nopasara/joystick/KiCad proj/joystick/joystick.kicad_pcb

## KiCad design KiCad proj/joystick/joystick.kicad_pcb (2022-01-29)

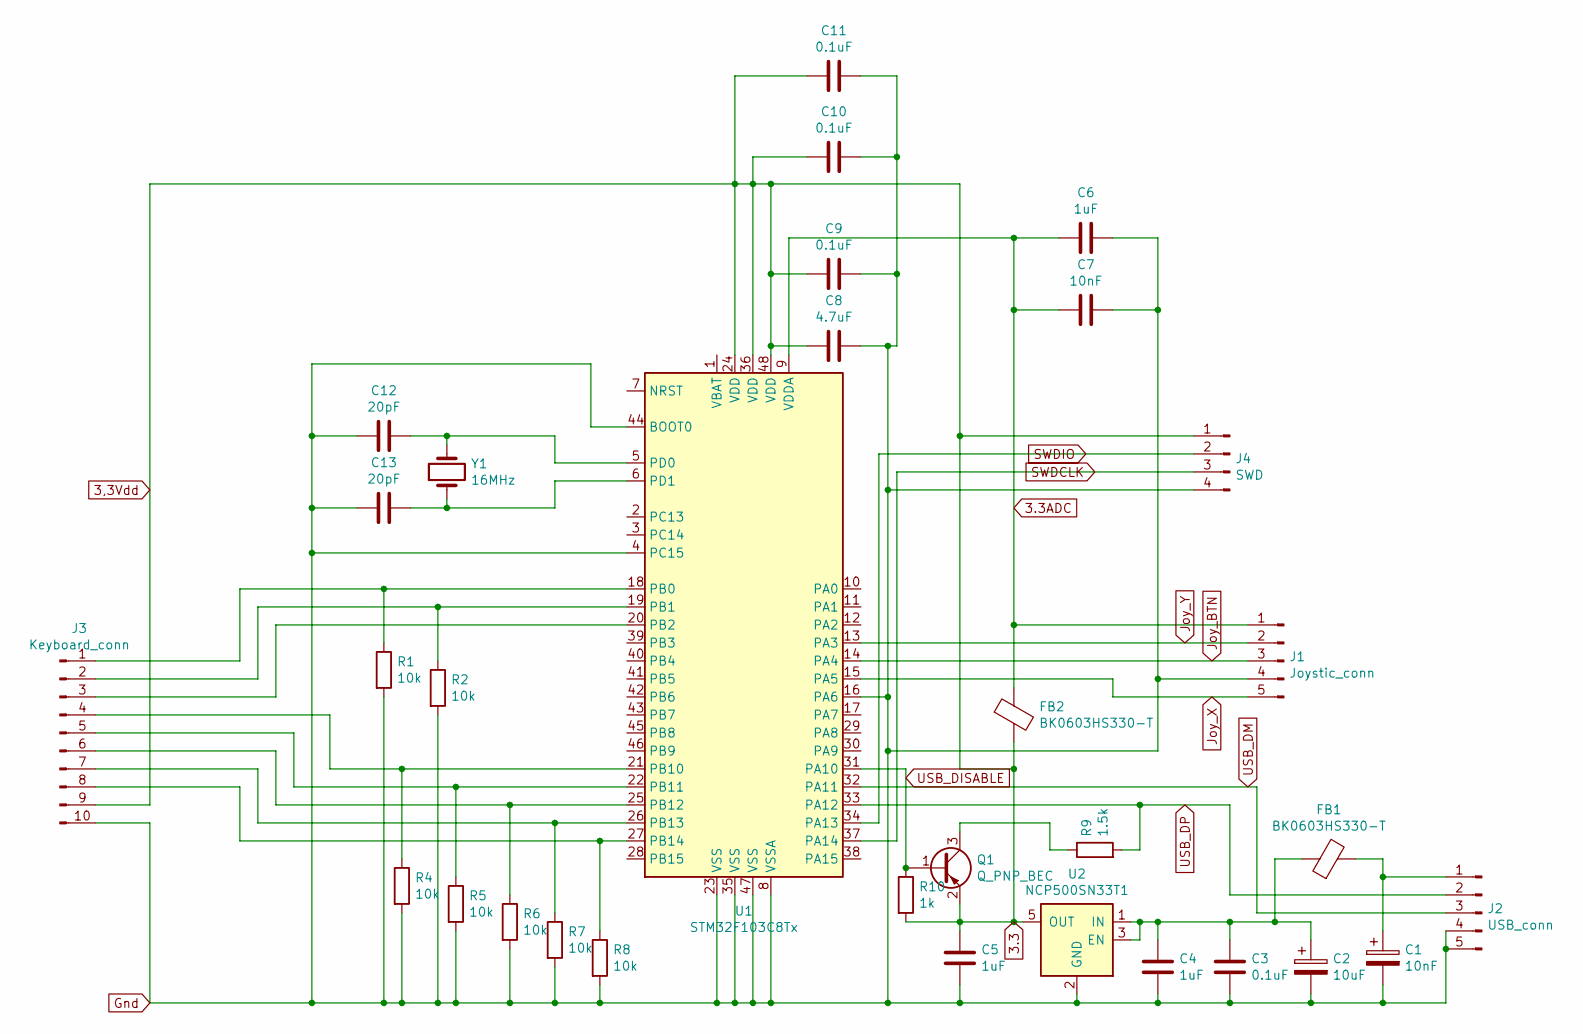
[picture p1: schematic joystick.sch]

Parts:
C1, C7: 10nF; C_0603_1608Metric_Pad1.08x0.95mm_HandSolder
C2: 10uF; CP_Radial_D5.0mm_P2.50mm
C3, C9, C10, C11: 0.1uF; C_0805_2012Metric_Pad1.18x1.45mm_HandSolder
C4, C5, C6: 1uF; C_0805_2012Metric_Pad1.18x1.45mm_HandSolder
C8: 4.7uF; CP_Radial_D5.0mm_P2.50mm
C12, C13: 20pF; C_0603_1608Metric_Pad1.08x0.95mm_HandSolder
FB1, FB2: BK0603HS330-T; R_0603_1608Metric_Pad0.98x0.95mm_HandSolder
J1: Joystic_conn; FPC-5P-0.5mm
J2: USB_conn; PinHeader_1x05_P2.54mm_Vertical
J3: Keyboard_conn; Hirose_FH12-10S-0.5SH_1x10-1MP_P0.50mm_Horizontal
J4: SWD; PinHeader_1x04_P2.54mm_Vertical
Q1: Q_PNP_BEC; SOT-23
R1, R2, R4, R5, R6, R7, R8: 10k; R_0201_0603Metric_Pad0.64x0.40mm_HandSolder
R9: 1.5k; C_0805_2012Metric_Pad1.18x1.45mm_HandSolder
R10: 1k; R_0603_1608Metric_Pad0.98x0.95mm_HandSolder
U1: STM32F103C8Tx; LQFP-48_7x7mm_P0.5mm
U2: NCP500SN33T1; TSOP-5_1.65x3.05mm_P0.95mm
Y1: 16MHz; Crystal_HC49-S_Vertical

Connections:
3,3Vdd: C5.1, C8.1, C9.1, C10.1, C11.1, FB2.2, J3.9, J4.1, Q1.2 (E), R10.2, U1.24 (VDD), U1.36 (VDD), U1.48 (VDD), U2.5 (OUT)
3.3ADC: C6.1, C7.1, FB2.1, J1.1, U1.9 (VDDA)
Gnd: C1.2, C2.2, C3.2, C4.2, C5.2, C6.2, C7.2, C8.2, C9.2, C10.2, C11.2, C12.1, C13.1, J1.4, J2.4, J2.5, J3.10, J4.4, R1.2, R2.2, R4.2, R5.2, R6.2, R7.2, R8.2, U1.4 (PC15), U1.8 (VSSA), U1.16 (PA6), U1.23 (VSS), U1.35 (VSS), U1.44 (BOOT0), U1.47 (VSS), U2.2 (GND)
Joy_BTN: J1.3, U1.14 (PA4)
Joy_X: J1.5, U1.15 (PA5)
Joy_Y: J1.2, U1.13 (PA3)
unnamed: C1.1, FB1.2, J2.1
unnamed: C2.1, C3.1, C4.1, FB1.1, U2.1 (IN), U2.3 (EN)
unnamed: C12.2, U1.5 (PD0), Y1.2
unnamed: C13.2, U1.6 (PD1), Y1.1
unnamed: J3.1, R1.1, U1.18 (PB0)
unnamed: J3.2, R2.1, U1.19 (PB1)
unnamed: J3.3, U1.20 (PB2)
unnamed: J3.4, R4.1, U1.21 (PB10)
unnamed: J3.5, R5.1, U1.22 (PB11)
unnamed: J3.6, R6.1, U1.25 (PB12)
unnamed: J3.7, R7.1, U1.26 (PB13)
unnamed: J3.8, R8.1, U1.27 (PB14)
unnamed: Q1.3 (C), R9.1
SWDCLK: J4.3, U1.37 (PA14)
SWDIO: J4.2, U1.34 (PA13)
USB_DISABLE: Q1.1 (B), R10.1, U1.31 (PA10)
USB_DM: J2.3, U1.32 (PA11)
USB_DP: J2.2, R9.2, U1.33 (PA12)

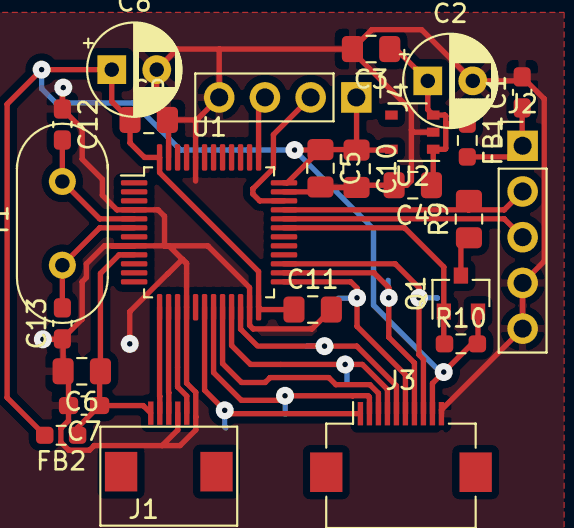
[picture p2: board joystick.kicad_pcb from above]

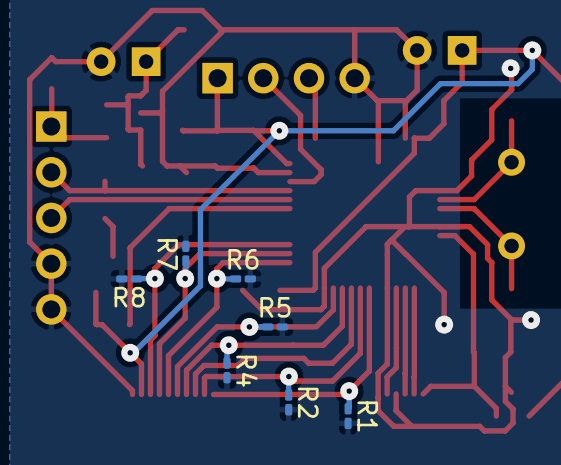
[picture p3: board joystick.kicad_pcb from below]

Board: 2 copper layers, 32 parts (7 on the bottom side), 24 nets.
