nopasara/joystick/KiCad proj/stick_adaptor2/stick_adaptor2.kicad_pcb

## KiCad design KiCad proj/stick_adaptor2/stick_adaptor2.kicad_pcb (2022-01-29)

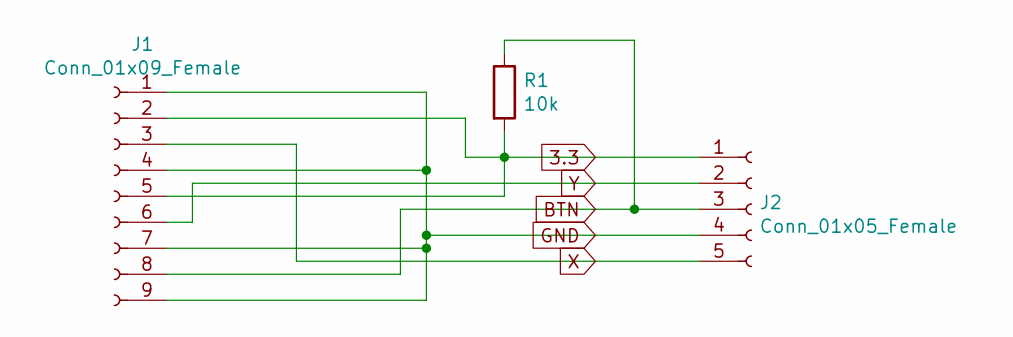
[picture p4: schematic stick_adaptor2.sch]

Parts:
J1: Conn_01x09_Female; Stick_china
J2: Conn_01x05_Female; PinHeader_1x05_P1.27mm_Vertical
R1: 10k; R_0603_1608Metric_Pad0.98x0.95mm_HandSolder

Connections:
3.3: J1.2, J1.5, J2.1, R1.2
BTN: J1.8, J2.3, R1.1
GND: J1.1, J1.4, J1.7, J1.9, J2.4
X: J1.3, J2.5
Y: J1.6, J2.2

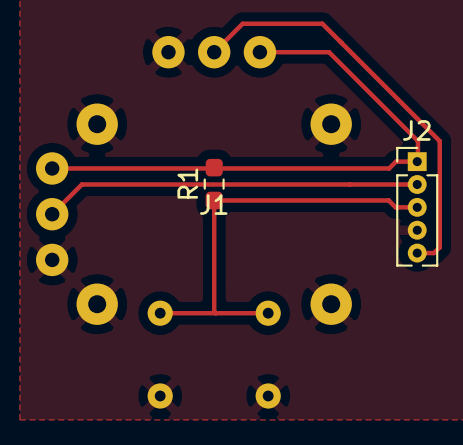
[picture p5: board stick_adaptor2.kicad_pcb from above]

Board: 2 copper layers, 3 parts (0 on the bottom side), 5 nets.
