nopasara/joystick/KiCad proj/joystick_v2/joystick_v2.kicad_pcb

## KiCad design KiCad proj/joystick_v2/joystick_v2.kicad_pcb (2022-01-29)

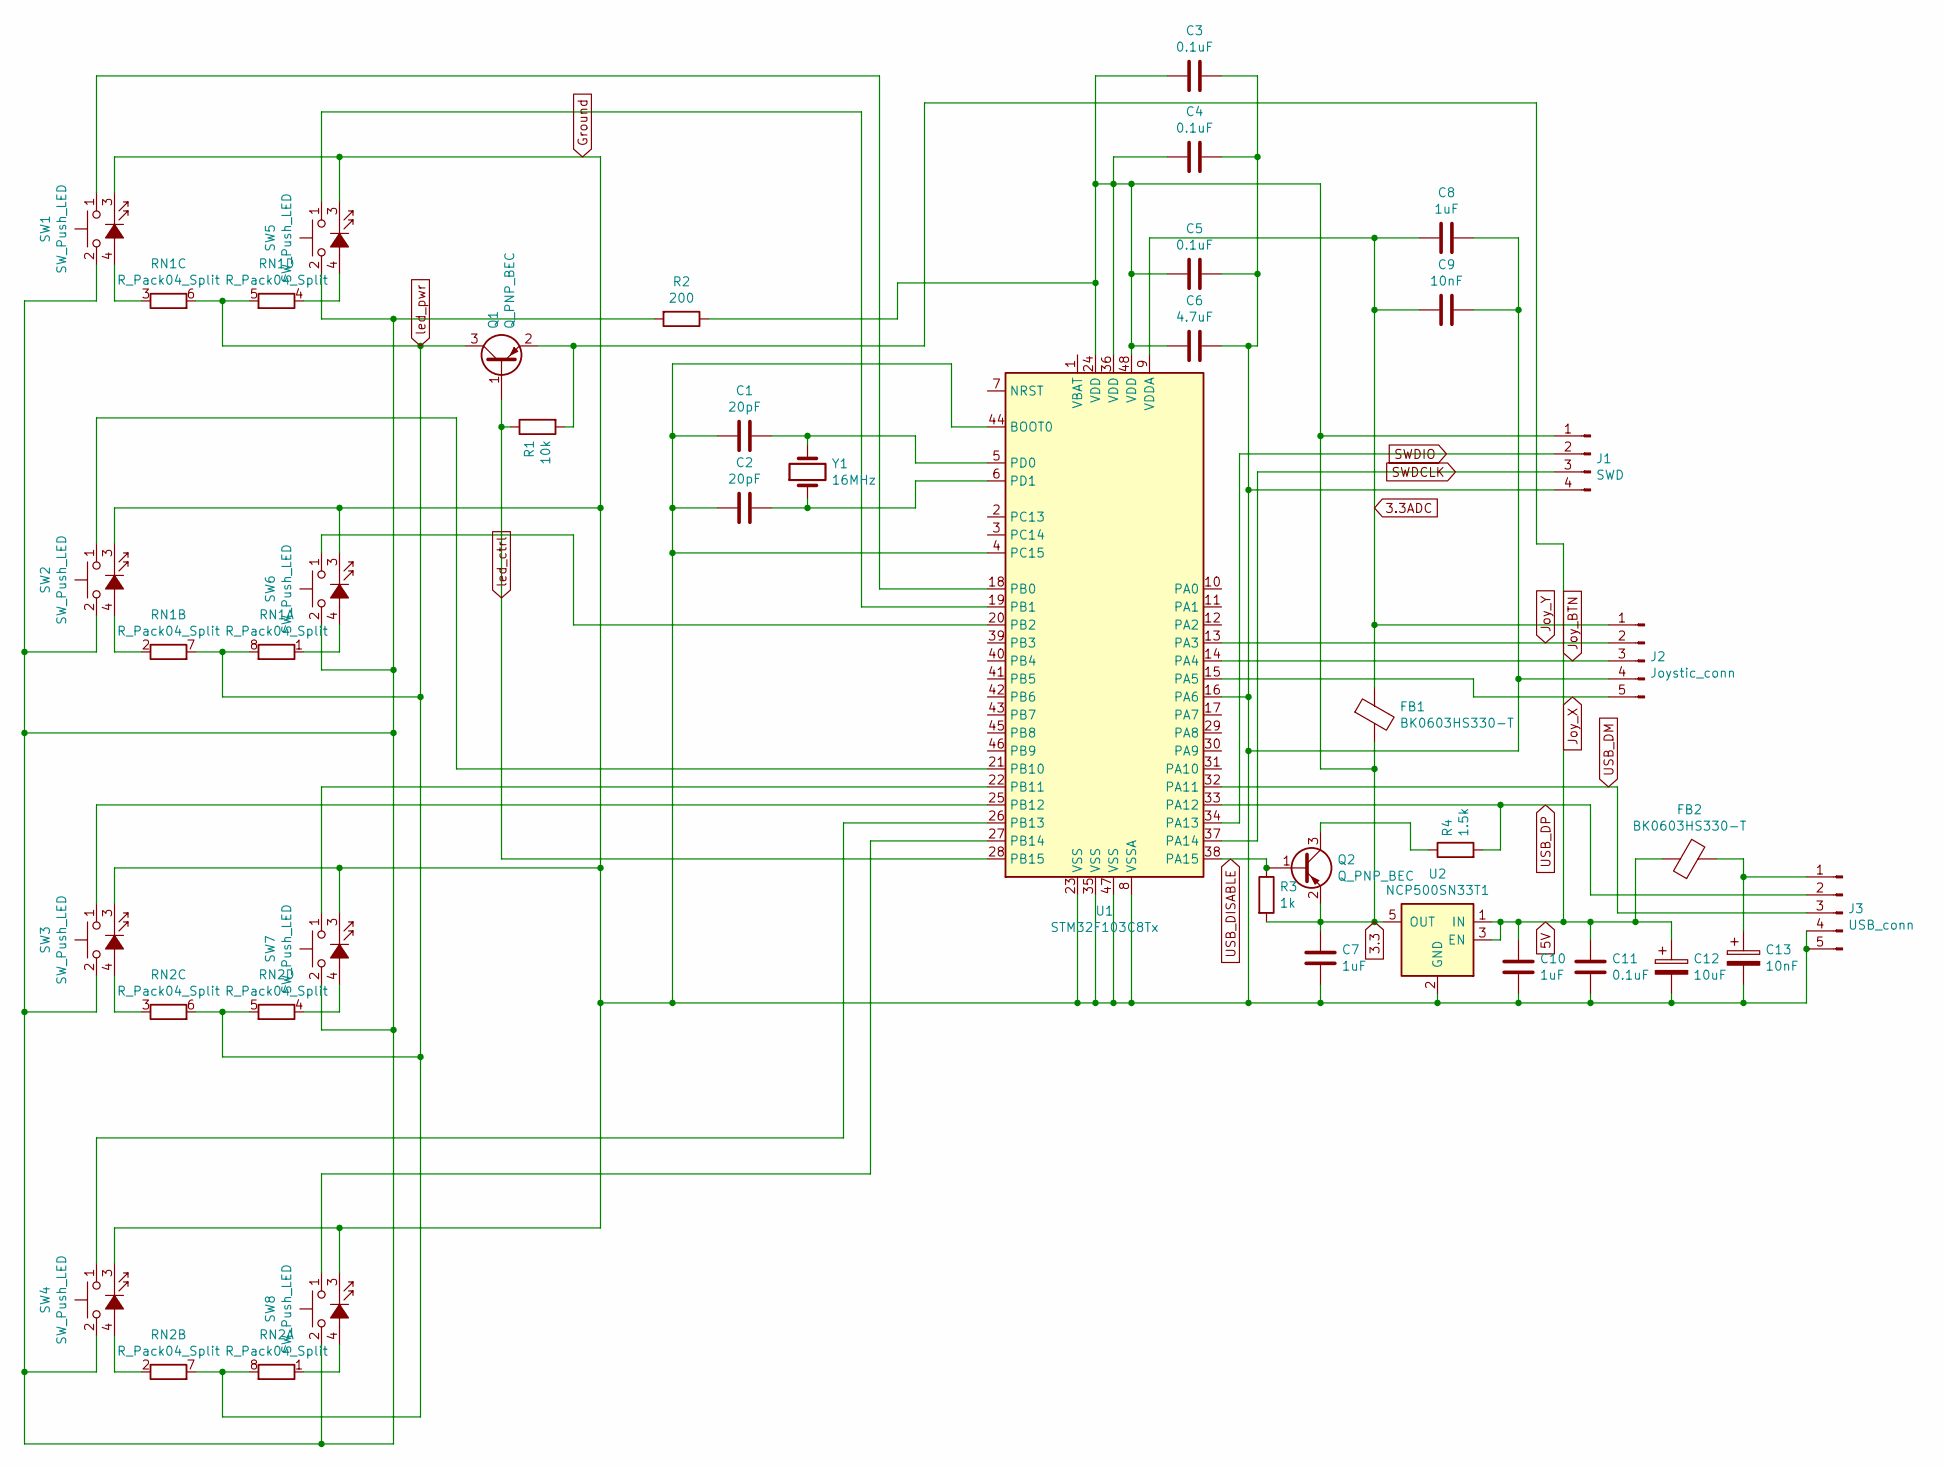
[picture p6: schematic joystick_v2.sch]

Parts:
C1, C2: 20pF; C_0603_1608Metric_Pad1.08x0.95mm_HandSolder
C3, C4, C5, C11: 0.1uF; C_0805_2012Metric_Pad1.18x1.45mm_HandSolder
C6: 4.7uF; CP_Radial_D5.0mm_P2.50mm
C7, C8, C10: 1uF; C_0805_2012Metric_Pad1.18x1.45mm_HandSolder
C9, C13: 10nF; C_0603_1608Metric_Pad1.08x0.95mm_HandSolder
C12: 10uF; CP_Radial_D5.0mm_P2.50mm
FB1, FB2: BK0603HS330-T; R_0603_1608Metric_Pad0.98x0.95mm_HandSolder
J1: SWD; PinHeader_1x04_P2.54mm_Vertical
J2: Joystic_conn; PinHeader_1x05_P1.27mm_Vertical
J3: USB_conn; PinHeader_1x05_P2.54mm_Vertical
Q1, Q2: Q_PNP_BEC; SOT-23
R1: 10k; R_0603_1608Metric_Pad0.98x0.95mm_HandSolder
R2: 200; R_0603_1608Metric_Pad0.98x0.95mm_HandSolder
R3: 1k; R_0603_1608Metric_Pad0.98x0.95mm_HandSolder
R4: 1.5k; C_0805_2012Metric_Pad1.18x1.45mm_HandSolder
RN1, RN2: R_Pack04_Split; R_Cat16-4
SW1, SW2, SW3, SW4, SW5, SW6, SW7, SW8: SW_Push_LED; SW_Cherry_MX_1.00u_Plate_diode
U1: STM32F103C8Tx; LQFP-48_7x7mm_P0.5mm
U2: NCP500SN33T1; TSOP-5_1.65x3.05mm_P0.95mm
Y1: 16MHz; Crystal_HC49-S_Vertical

Connections:
3.3: C3.1, C4.1, C5.1, C6.1, C7.1, FB1.2, J1.1, Q2.2 (E), R2.1, R3.2, U1.24 (VDD), U1.36 (VDD), U1.48 (VDD), U2.5 (OUT)
3.3ADC: C8.1, C9.1, FB1.1, J2.1, U1.9 (VDDA)
5V: C10.1, C11.1, C12.1, FB2.1, Q1.2 (E), R1.2, U2.1 (IN), U2.3 (EN)
Ground: C1.1, C2.1, C3.2, C4.2, C5.2, C6.2, C7.2, C8.2, C9.2, C10.2, C11.2, C12.2, C13.2, J1.4, J2.4, J3.4, J3.5, SW1.3 (K), SW2.3 (K), SW3.3 (K), SW4.3 (K), SW5.3 (K), SW6.3 (K), SW7.3 (K), SW8.3 (K), U1.4 (PC15), U1.8 (VSSA), U1.16 (PA6), U1.23 (VSS), U1.35 (VSS), U1.44 (BOOT0), U1.47 (VSS), U2.2 (GND)
Joy_BTN: J2.3, U1.14 (PA4)
Joy_X: J2.5, U1.15 (PA5)
Joy_Y: J2.2, U1.13 (PA3)
unnamed: C1.2, U1.5 (PD0), Y1.2
unnamed: C2.2, U1.6 (PD1), Y1.1
unnamed: C13.1, FB2.2, J3.1
unnamed: Q2.3 (C), R4.1
unnamed: R2.2, SW1.2, SW2.2, SW3.2, SW4.2, SW5.2, SW6.2, SW7.2, SW8.2
unnamed: RN1.1 (R1.1), SW6.4 (A)
unnamed: RN1.2 (R2.1), SW2.4 (A)
unnamed: RN1.3 (R3.1), SW1.4 (A)
unnamed: RN1.4 (R4.1), SW5.4 (A)
unnamed: RN2.1 (R1.1), SW8.4 (A)
unnamed: RN2.2 (R2.1), SW4.4 (A)
unnamed: RN2.3 (R3.1), SW3.4 (A)
unnamed: RN2.4 (R4.1), SW7.4 (A)
unnamed: SW1.1, U1.18 (PB0)
unnamed: SW2.1, U1.21 (PB10)
unnamed: SW3.1, U1.25 (PB12)
unnamed: SW4.1, U1.26 (PB13)
unnamed: SW5.1, U1.19 (PB1)
unnamed: SW6.1, U1.20 (PB2)
unnamed: SW7.1, U1.22 (PB11)
unnamed: SW8.1, U1.27 (PB14)
SWDCLK: J1.3, U1.37 (PA14)
SWDIO: J1.2, U1.34 (PA13)
USB_DISABLE: Q2.1 (B), R3.1, U1.38 (PA15)
USB_DM: J3.3, U1.32 (PA11)
USB_DP: J3.2, R4.2, U1.33 (PA12)
led_ctrl: Q1.1 (B), R1.1, U1.28 (PB15)
led_pwr: Q1.3 (C), RN1.5 (R4.2), RN1.6 (R3.2), RN1.7 (R2.2), RN1.8 (R1.2), RN2.5 (R4.2), RN2.6 (R3.2), RN2.7 (R2.2), RN2.8 (R1.2)

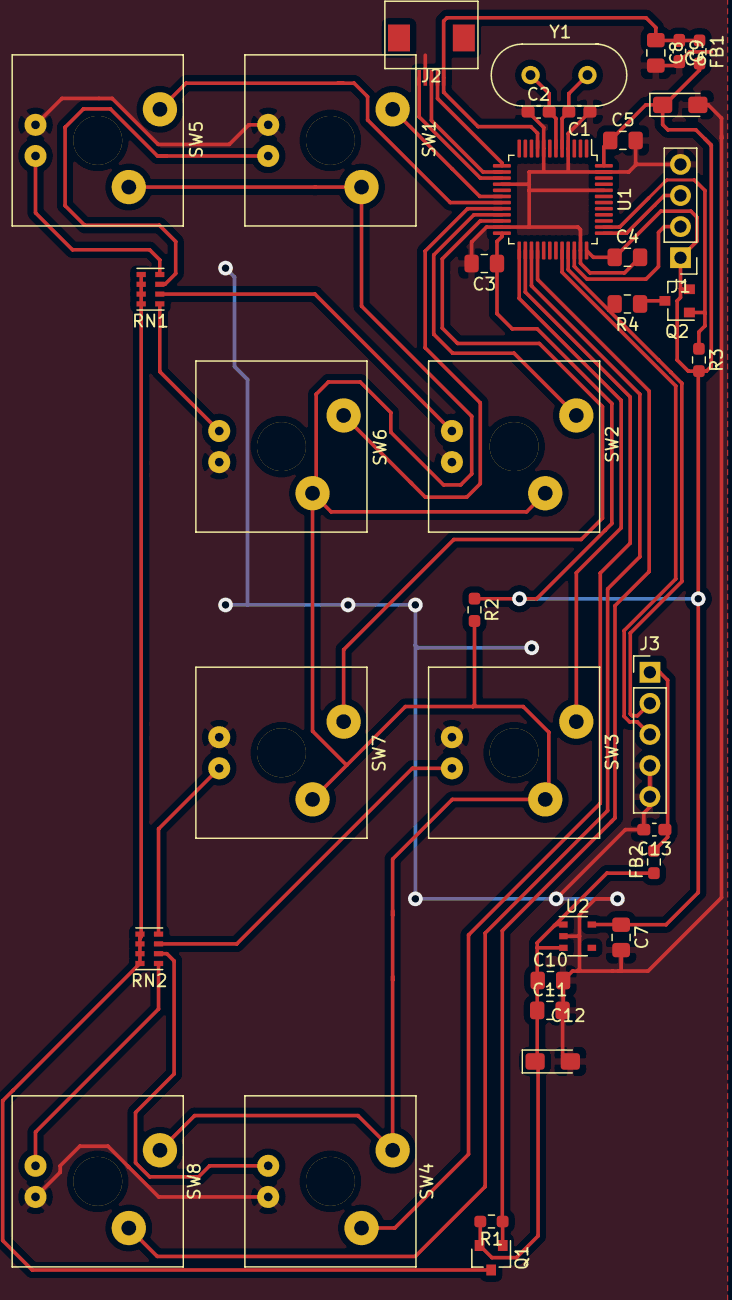
[picture p7: board joystick_v2.kicad_pcb from above]

Board: 2 copper layers, 37 parts (0 on the bottom side), 35 nets.
