nopasara/joystick/KiCad proj/keypad/keypad.kicad_pcb

## KiCad design KiCad proj/keypad/keypad.kicad_pcb (2021-08-06)

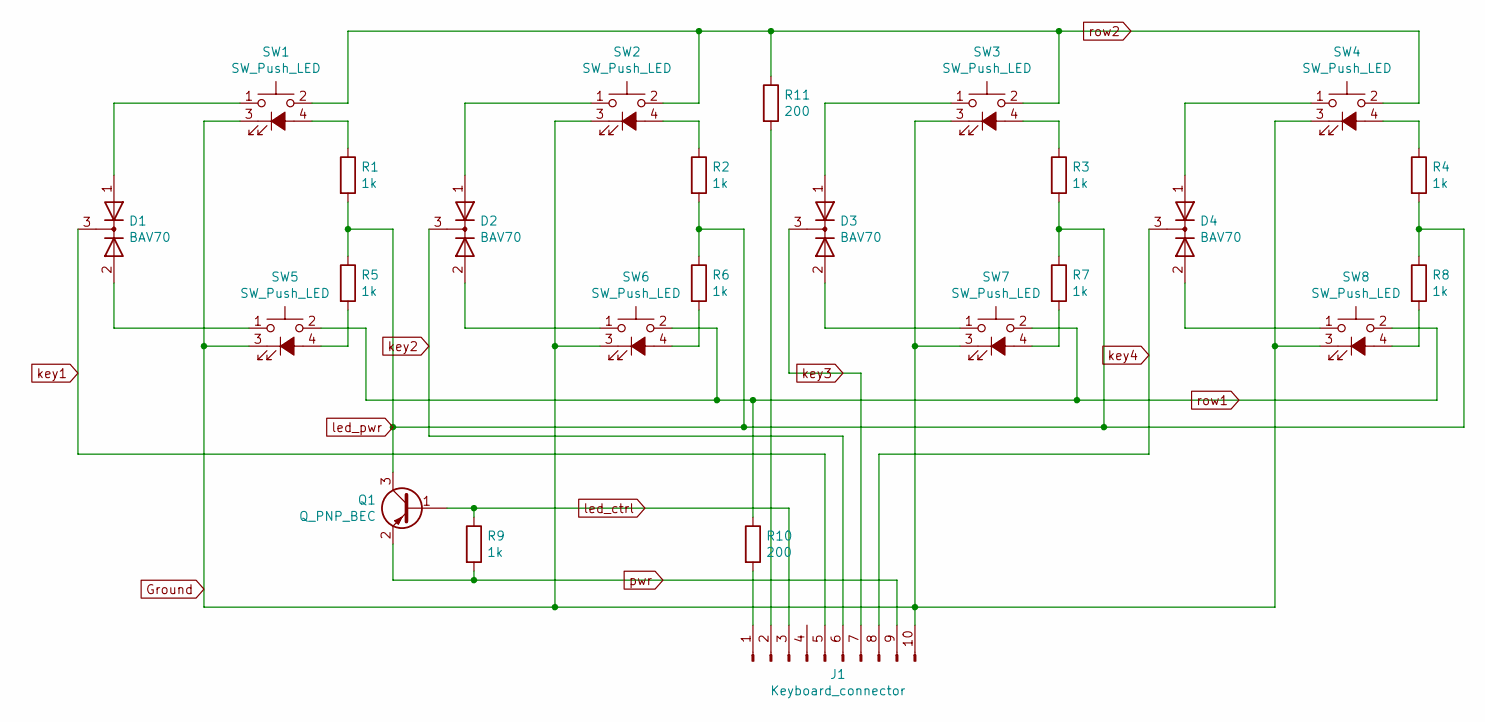
[picture p8: schematic keypad.sch]

Parts:
D1, D2, D3, D4: BAV70; SOT-23
J1: Keyboard_connector; Hirose_FH12-10S-0.5SH_1x10-1MP_P0.50mm_Horizontal
Q1: Q_PNP_BEC; SOT-23
R1, R2, R3, R4, R5, R6, R7, R8, R9: 1k; R_0603_1608Metric_Pad0.98x0.95mm_HandSolder
R10, R11: 200; R_0603_1608Metric_Pad0.98x0.95mm_HandSolder
SW1, SW2, SW3, SW4, SW5, SW6, SW7, SW8: SW_Push_LED; PinHeader_1x04_P2.54mm_Vertical

Connections:
Ground: J1.10, SW1.3 (K), SW2.3 (K), SW3.3 (K), SW4.3 (K), SW5.3 (K), SW6.3 (K), SW7.3 (K), SW8.3 (K)
unnamed: D1.1 (A), SW1.1
unnamed: D1.2 (A), SW5.1
unnamed: D2.1 (A), SW2.1
unnamed: D2.2 (A), SW6.1
unnamed: D3.1 (A), SW3.1
unnamed: D3.2 (A), SW7.1
unnamed: D4.1 (A), SW4.1
unnamed: D4.2 (A), SW8.1
unnamed: J1.1, R10.2
unnamed: J1.2, R11.2
unnamed: R1.1, SW1.4 (A)
unnamed: R2.1, SW2.4 (A)
unnamed: R3.1, SW3.4 (A)
unnamed: R4.1, SW4.4 (A)
unnamed: R5.2, SW5.4 (A)
unnamed: R6.2, SW6.4 (A)
unnamed: R7.2, SW7.4 (A)
unnamed: R8.2, SW8.4 (A)
key1: D1.3 (K), J1.5
key2: D2.3 (K), J1.6
key3: D3.3 (K), J1.7
key4: D4.3 (K), J1.8
led_ctrl: J1.3, Q1.1 (B), R9.1
led_pwr: Q1.3 (C), R1.2, R2.2, R3.2, R4.2, R5.1, R6.1, R7.1, R8.1
pwr: J1.9, Q1.2 (E), R9.2
row1: R10.1, SW5.2, SW6.2, SW7.2, SW8.2
row2: R11.1, SW1.2, SW2.2, SW3.2, SW4.2

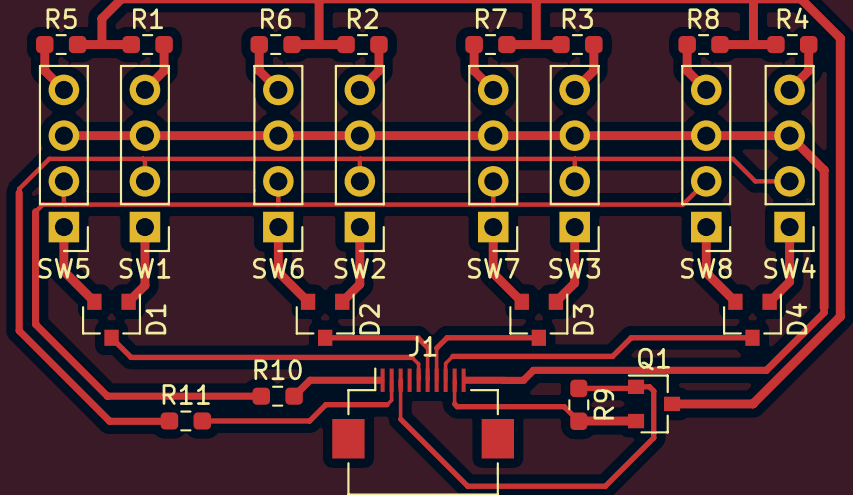
[picture p9: board keypad.kicad_pcb from above]

Board: 2 copper layers, 25 parts (0 on the bottom side), 28 nets.
