nopasara/joystick/src/main.c

/**
  ******************************************************************************
  * @file    main.c
  * @author  MCD Application Team
  * @version V4.1.0
  * @date    26-May-2017
  * @brief   Joystick Mouse demo main file
  ******************************************************************************
  * @attention
  *
  * <h2><center>&copy; COPYRIGHT(c) 2017 STMicroelectronics</center></h2>
  *
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
  ******************************************************************************
  */


/* Includes ------------------------------------------------------------------*/
#include "hw_config.h"
/* Private typedef -----------------------------------------------------------*/
/* Private define ------------------------------------------------------------*/
/* Private macro -------------------------------------------------------------*/
/* Private variables ---------------------------------------------------------*/
__IO uint8_t PrevXferComplete = 1;
RCC_ClocksTypeDef RCC_ClockFreq;
extern int JoystickCalibrated;

/* Buffer aligned to uint16_t since PMAtoUserCopy function has memory corruption bug */
__IO uint8_t SetRepBuff[sizeof(calib_data_t) + 2];
/* Extern variables ----------------------------------------------------------*/
/* Private function prototypes -----------------------------------------------*/
/* Private functions ---------------------------------------------------------*/

/*******************************************************************************
* Function Name  : main.
* Description    : main routine.
* Input          : None.
* Output         : None.
* Return         : None.
*******************************************************************************/
int main(void)
{
  JoySettings_t JoySet;
  uint8_t sched = 0;

  Set_System();

  USB_Interrupts_Config();

  Set_USBClock();

  USB_Init();

  Joystick_setup(CalData, &JoySet);

  while (1) {
    if (bDeviceState == CONFIGURED) {
      if (SetRepBuff[0] == REP_CALIBRATE) {
        calibrate_cmd_process(SetRepBuff, &CalData, &JoySet);
      }
      if (PrevXferComplete) {
        if (sched && JoystickCalibrated) {
          Joystick_Send(CalData, &JoySet);
        } else {
          Keyboard_Send(CalData);
        }
        sched ^= 1;
      }
    }
  }
}

#ifdef  USE_FULL_ASSERT
/*******************************************************************************
* Function Name  : assert_failed
* Description    : Reports the name of the source file and the source line number
*                  where the assert_param error has occurred.
* Input          : - file: pointer to the source file name
*                  - line: assert_param error line source number
* Output         : None
* Return         : None
*******************************************************************************/
void assert_failed(uint8_t* file, uint32_t line)
{
  /* User can add his own implementation to report the file name and line number,
     ex: printf("Wrong parameters value: file %s on line %d\r\n", file, line) */

  /* Infinite loop */
  while (1)
  {}
}
#endif

/************************ (C) COPYRIGHT STMicroelectronics *****END OF FILE****/
