nopasara/joystick/src/hw_config.c

/**
  ******************************************************************************
  * @file    hw_config.c
  * @author  MCD Application Team
  * @version V4.1.0
  * @date    26-May-2017
  * @brief   Hardware Configuration & Setup
  ******************************************************************************
  * @attention
  *
  * <h2><center>&copy; COPYRIGHT(c) 2017 STMicroelectronics</center></h2>
  *
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
  ******************************************************************************
  */

/* Includes ------------------------------------------------------------------*/
#include "hw_config.h"

/* Private typedef -----------------------------------------------------------*/
enum calib_cmd_type {
    CALIBRATE_RANGE,
    CALIBRATE_RANGE_STOP,
    CALIBRATE_AVG,
    CALIBRATE_AVG_STOP,
    CALIBRATE_MANUAL,
    CALIBRATE_SHOW,
    CALIBRATE_DEBUG,
};

/* Private define ------------------------------------------------------------*/
#define AXIS_MAX_VAL                    (127)
/* ln(128) */
#define EXP_COEF                        (4.852)
/* Private macro -------------------------------------------------------------*/
/* Private variables ---------------------------------------------------------*/
ErrorStatus HSEStartUpStatus;
uint16_t X, Y;
int JoystickCalibrated;
const uint16_t keys[NUM_KEYS] = {KEY_0, KEY_1, KEY_2, KEY_3,
                                 KEY_4, KEY_5, KEY_6, KEY_7};

/* Extern variables ----------------------------------------------------------*/
extern __IO uint8_t PrevXferComplete;

/* Private function prototypes -----------------------------------------------*/
static void IntToUnicode (uint32_t value , uint8_t *pbuf , uint8_t len);
static void Delay(__IO uint32_t nTime);
static void TIM1_Configuration(void);
static void ADC_Configuration(void);
static void TIM1_Interrupts_Config(void);
/* Private functions ---------------------------------------------------------*/

/**
  * Function Name  : Set_System
  * Description    : Configures Main system clocks & power.
  * Input          : None.
  * Return         : None.
  */
void Set_System(void)
{
  GPIO_InitTypeDef  GPIO_InitStructure;  
  /*!< At this stage the microcontroller clock setting is already configured, 
       this is done through SystemInit() function which is called from startup
       file (startup_stm32xxx.s) before to branch to application main.
       To reconfigure the default setting of SystemInit() function, refer to
       system_stm32xxx.c file
     */ 

  /* Disable JTAG */
  RCC_APB2PeriphClockCmd(RCC_APB2Periph_AFIO, ENABLE);
  GPIO_PinRemapConfig(GPIO_Remap_SWJ_JTAGDisable, ENABLE);

  /******************************************/
  /*           Enable the PWR clock         */
  /******************************************/
  /* Enable all GPIOs Clock*/
  RCC_APB2PeriphClockCmd(RCC_APB2Periph_ALLGPIO, ENABLE);

  /********************************************/
  /*  Configure USB DM/DP pins                */
  /********************************************/
  GPIO_InitStructure.GPIO_Pin = GPIO_Pin_11 | GPIO_Pin_12;
  GPIO_InitStructure.GPIO_Speed = GPIO_Speed_50MHz;
  GPIO_InitStructure.GPIO_Mode = GPIO_Mode_AF_PP;
  GPIO_Init(GPIOA, &GPIO_InitStructure);

  /********************************************/
  /*  Enable joystick pins                    */
  /********************************************/
  GPIO_InitStructure.GPIO_Pin = JS_ADC1_PIN | JS_ADC2_PIN;
  GPIO_InitStructure.GPIO_Speed = GPIO_Speed_50MHz;
  GPIO_InitStructure.GPIO_Mode = GPIO_Mode_AIN;
  GPIO_Init(JS_PORT, &GPIO_InitStructure);

  /********************************************/
  /*  Enable keyboard pins                    */
  /********************************************/
  GPIO_InitStructure.GPIO_Pin = KEY_LED;
  GPIO_InitStructure.GPIO_Speed = GPIO_Speed_50MHz;
  GPIO_InitStructure.GPIO_Mode = GPIO_Mode_Out_OD;
  GPIO_Init(KEY_PORT, &GPIO_InitStructure);

  GPIO_WriteBit(KEY_PORT, KEY_LED, Bit_RESET);

  GPIO_InitStructure.GPIO_Pin = KEY_MASK;
  GPIO_InitStructure.GPIO_Speed = GPIO_Speed_50MHz;
  GPIO_InitStructure.GPIO_Mode = GPIO_Mode_IPD;
  GPIO_Init(KEY_PORT, &GPIO_InitStructure);

  /********************************************/
  /* Enable the USB PULL UP                   */
  /********************************************/
  /* USB_DISCONNECT used as USB pull-up */
  GPIO_InitStructure.GPIO_Pin = USB_DISCONNECT_PIN;
  GPIO_InitStructure.GPIO_Speed = GPIO_Speed_50MHz;
  GPIO_InitStructure.GPIO_Mode = GPIO_Mode_Out_OD;
  GPIO_Init(USB_DISCONNECT, &GPIO_InitStructure);

  GPIO_WriteBit(USB_DISCONNECT, USB_DISCONNECT_PIN, Bit_SET);

  /********************************************/
  /*   configures the hardware resources      */
  /********************************************/

  /* 2 bit for pre-emption priority, 2 bits for subpriority */
  NVIC_PriorityGroupConfig(NVIC_PriorityGroup_2);

  TIM1_Configuration();
  ADC_Configuration();
  CalData = flash_claib_find((calib_data_t *)&_calibdata);
  JoystickCalibrated = flash_check_calibrated(CalData);
}

/*******************************************************************************
* Function Name : TIM1_Configuration.
* Description   : Configure the TIM1.
* Input         : None.
* Output        : None.
* Return value  : None.
*******************************************************************************/
static void TIM1_Configuration(void)
{
    /* 72 MHz - 1 second event */
    TIM_TimeBaseInitTypeDef TIM1_settings = {
        .TIM_Prescaler          = 0xFFFF,
        .TIM_CounterMode        = TIM_CounterMode_Up,
        .TIM_Period             = 1100,
        .TIM_ClockDivision      = TIM_CKD_DIV1,
        .TIM_RepetitionCounter  = 0};

    RCC_APB2PeriphClockCmd(RCC_APB2Periph_TIM1, ENABLE);
    TIM_UpdateRequestConfig(TIM1, TIM_UpdateSource_Regular);
    TIM_TimeBaseInit(TIM1, &TIM1_settings);
    TIM_ITConfig(TIM1, TIM_IT_Update, ENABLE);
    TIM1_Interrupts_Config();
}

/*******************************************************************************
* Function Name : ADC_Configuration.
* Description   : Configure the ADC1 and ADC2 in double mode.
* Input         : None.
* Output        : None.
* Return value  : None.
*******************************************************************************/
static void ADC_Configuration(void)
{
  ADC_InitTypeDef ADC_settings = {  .ADC_Mode = ADC_Mode_RegSimult,
                                    .ADC_ScanConvMode = DISABLE,
                                    .ADC_ContinuousConvMode = DISABLE,
                                    .ADC_ExternalTrigConv = ADC_ExternalTrigConv_None,
                                    .ADC_DataAlign = ADC_DataAlign_Right,
                                    .ADC_NbrOfChannel = ADC_CH_COUNT};

  RCC_ADCCLKConfig(RCC_PCLK2_Div6);
  RCC_APB2PeriphClockCmd(RCC_APB2Periph_ADC1, ENABLE);
  RCC_APB2PeriphClockCmd(RCC_APB2Periph_ADC2, ENABLE);
  for (register int i = 1; i <= ADC_CH_COUNT; i++) {
    ADC_RegularChannelConfig(ADC1, JS_ADC1, i, ADC_SampleTime_239Cycles5);
    ADC_RegularChannelConfig(ADC2, JS_ADC2, i, ADC_SampleTime_239Cycles5);
  }
  ADC_ExternalTrigConvCmd(ADC2, ENABLE);
  ADC_Init(ADC1, &ADC_settings);
  ADC_Init(ADC2, &ADC_settings);
  ADC_Cmd(ADC1, ENABLE);
  ADC_Cmd(ADC2, ENABLE);
  /* >2 ADC clock delay */
  ADC_CYC_DELAY(3);

  ADC_ResetCalibration(ADC1);
  ADC_ResetCalibration(ADC2);
  while(ADC_GetResetCalibrationStatus(ADC2));

  ADC_StartCalibration(ADC1);
  ADC_StartCalibration(ADC2);

  while(ADC_GetCalibrationStatus(ADC2) != RESET) {}
}

void ADC_avg_read(uint32_t iter, uint16_t *adc1_val, uint16_t *adc2_val)
{
  register int tmp_1 = *adc1_val, tmp_2 = *adc2_val;

  for (register int j = 0; j < iter; j++) {
    /* >14 ADC clock delay */
    ADC_CYC_DELAY(15);
    ADC_SoftwareStartConvCmd(ADC1, ENABLE);
    for (register int i = 0; i < ADC_CH_COUNT; i++) {
      while (ADC_GetFlagStatus(ADC1, ADC_FLAG_EOC) != SET) {}
      int count = (j * ADC_CH_COUNT) + i + 1;
      uint32_t c_val1 = ADC_GetConversionValue(ADC1);
      uint32_t c_val2 = ADC_GetConversionValue(ADC2);

      tmp_1 += ((int)(c_val1 & 0xffff) - tmp_1) / count;
      tmp_2 += ((int)(c_val2 & 0xffff) - tmp_2) / count;
    }
  }

  *adc1_val = tmp_1;
  *adc2_val = tmp_2;
}

/**
  * Function Name  : Signal_Unconfigured.
  * Description    : Signal by the led flashing that the joystick is
  *                  unconfigured.
  * Input          : ENABLE - Enable or disabe the led flashing.
  * Output         : None.
  * Return         : None.
  */
void Signal_Unconfigured(uint8_t enable)
{
    if (enable) {
        TIM_Cmd(TIM1, ENABLE);
    } else {
        TIM_Cmd(TIM1, DISABLE);
    }
}

/**
  * Function Name  : Joystick_Setup.
  * Description    : Fill the joystick setup structure.
  * Input          : cal_data - calibration data structure
  *                  set - joystick settings structure
  * Output         : None.
  * Return         : None.
  */
void Joystick_setup(calib_data_t *cal_data, JoySettings_t *set)
{
    if (!JoystickCalibrated) {
        set->X_map = &X;
        set->Y_map = &Y;
        Signal_Unconfigured(ENABLE);
        return;
    }

    if (cal_data->st.axis_rev) {
        set->X_map = &Y;
        set->Y_map = &X;
    } else {
        set->X_map = &X;
        set->Y_map = &Y;
    }

    uint16_t x_range = cal_data->st.Xmax - cal_data->st.Xavg;
    uint16_t y_range = cal_data->st.Ymax - cal_data->st.Yavg;
    uint16_t max_range = MAX(x_range, y_range);

    set->x_norm_coef = (float)max_range / x_range;
    set->y_norm_coef = (float)max_range / y_range;

    uint16_t scens_rng = max_range - cal_data->st.R;

    set->step_coef = (float)EXP_COEF / scens_rng;
}

/**
  * Function Name  : Set_USBClock
  * Description    : Configures USB Clock input (48MHz).
  * Input          : None.
  * Output         : None.
  * Return         : None.
  */
void Set_USBClock(void)
{
  /* Select USBCLK source */
  RCC_USBCLKConfig(RCC_USBCLKSource_PLLCLK_1Div5);
  /* Enable the USB clock */
  RCC_APB1PeriphClockCmd(RCC_APB1Periph_USB, ENABLE);
}

/**
  * Function Name  : Leave_LowPowerMode.
  * Description    : Restores system clocks and power while exiting suspend mode.
  * Input          : None.
  * Output         : None.
  * Return         : None.
  */
void Leave_LowPowerMode(void)
{
  DEVICE_INFO *pInfo = &Device_Info;

  /* Set the device state to the correct state */
  if (pInfo->Current_Configuration != 0)
  {
    /* Device configured */
    bDeviceState = CONFIGURED;
  }
  else
  {
    bDeviceState = ATTACHED;
  }

#ifdef USB_LOW_PWR_MGMT_SUPPORT
  /* Reset SLEEPDEEP bit of Cortex System Control Register */
  SCB->SCR &= (uint32_t)~((uint32_t)(SCB_SCR_SLEEPDEEP_Msk | SCB_SCR_SLEEPONEXIT_Msk));

  /*Enable SystemCoreClock*/
  SystemInit();

#endif /* USB_LOW_PWR_MGMT_SUPPORT */
}

/**
  * Function Name  : USB_Interrupts_Config.
  * Description    : Configures the USB interrupts.
  * Input          : None.
  * Output         : None.
  * Return         : None.
  */
void USB_Interrupts_Config(void)
{
  NVIC_InitTypeDef NVIC_InitStructure;

  /* Enable the USB interrupt */
  NVIC_InitStructure.NVIC_IRQChannel = USB_LP_CAN1_RX0_IRQn;
  NVIC_InitStructure.NVIC_IRQChannelPreemptionPriority = 5;
  NVIC_InitStructure.NVIC_IRQChannelSubPriority = 0;
  NVIC_InitStructure.NVIC_IRQChannelCmd = ENABLE;
  NVIC_Init(&NVIC_InitStructure);

#ifdef USB_LOW_PWR_MGMT_SUPPORT
  /* Enable the USB Wake-up interrupt */
  NVIC_InitStructure.NVIC_IRQChannel = USBWakeUp_IRQn;
  NVIC_InitStructure.NVIC_IRQChannelPreemptionPriority = 0;
  NVIC_InitStructure.NVIC_IRQChannelSubPriority = 0;
  NVIC_Init(&NVIC_InitStructure); 
#endif /* USB_LOW_PWR_MGMT_SUPPORT */ 
}

/**
  * Function Name  : TIM1_Interrupts_Config.
  * Description    : Configures the TIM1 interrupt.
  * Input          : None.
  * Output         : None.
  * Return         : None.
  */
static void TIM1_Interrupts_Config(void)
{
  NVIC_InitTypeDef NVIC_InitStructure;

  /* Enable the USB interrupt */
  NVIC_InitStructure.NVIC_IRQChannel = TIM1_UP_IRQn;
  NVIC_InitStructure.NVIC_IRQChannelPreemptionPriority = 6;
  NVIC_InitStructure.NVIC_IRQChannelSubPriority = 0;
  NVIC_InitStructure.NVIC_IRQChannelCmd = ENABLE;
  NVIC_Init(&NVIC_InitStructure);
}

/**
  * Function Name  : USB_Cable_Config.
  * Description    : Software Connection/Disconnection of USB Cable.
  * Input          : NewState: new state.
  * Output         : None.
  * Return         : None
  */
void USB_Cable_Config (FunctionalState NewState)
{
  if (NewState != DISABLE)
  {
    GPIO_ResetBits(USB_DISCONNECT, USB_DISCONNECT_PIN);
  }
  else
  {
    GPIO_SetBits(USB_DISCONNECT, USB_DISCONNECT_PIN);
  }
}

/**
  * Function Name : joy_btn_state.
  * Description   : Get joystick button state
  * Input         : None.
  * Output        : None.
  * Return value  : 1 if button is pushed,
  *                 0 if button released
  */
uint8_t joy_btn_state(void)
{
    return ((GPIO_ReadInputDataBit(JS_PORT, JS_BTN_PIN)) ? 0 : 1);
}

/**
  * Function Name : Joystick_Send.
  * Description   : prepares buffer to be sent containing Joystick event infos.
  * Input         : set - joystick settings.
  * Output        : None.
  * Return value  : None.
  */
void Joystick_Send(calib_data_t *cal, JoySettings_t *set)
{
  uint8_t Mouse_Buffer[5] = {1, 0, 0, 0};
  uint8_t X_norm, Y_norm;
  uint32_t Rvect;
  int8_t  X_sign, Y_sign;
  static uint8_t btn_last;
  float x_coef, y_coef;

  /* maps global variables X and Y to HW ADCs */
  ADC_avg_read(ADC_SAMPLE_COUNT, set->X_map, set->Y_map);
  /* Center and adjust AXIS */
  if (X > cal->st.Xavg) {
    X -= cal->st.Xavg;
    X_sign = (cal->st.l_r_rev) ? -1 : 1;
  } else {
    X = cal->st.Xavg - X;
    X_sign = (cal->st.l_r_rev) ? 1 : -1;
  }
  if (Y > cal->st.Yavg) {
    Y -= cal->st.Yavg;
    Y_sign = (cal->st.u_d_rev) ? -1 : 1;
  } else {
    Y = cal->st.Yavg - Y;
    Y_sign = (cal->st.u_d_rev) ? 1 : -1;
  }

  X *= set->x_norm_coef;
  Y *= set->y_norm_coef;

  Rvect = sqrt((X * X) + (Y * Y));
  x_coef = (float)X / Rvect;
  y_coef = (float)Y / Rvect;

  if (Rvect > cal->st.R) {
    Rvect = exp((float)(Rvect - cal->st.R) * set->step_coef) - 1;

    X = Rvect * x_coef;
    if (X > AXIS_MAX_VAL) {
        X = AXIS_MAX_VAL;
    }
    X_sign *= X;

    Y = Rvect * y_coef;
    if (Y > AXIS_MAX_VAL) {
        Y = AXIS_MAX_VAL;
    }
    Y_sign *= Y;
  } else {
      X_sign = 0;
      Y_sign = 0;
  }

  if (X_sign != 0 || Y_sign != 0 || btn_last != joy_btn_state()) {
    btn_last = joy_btn_state();
    Mouse_Buffer[1] = btn_last;
    Mouse_Buffer[2] = X_sign;
    Mouse_Buffer[3] = Y_sign;

    /* Reset the control token to inform upper layer that a transfer is ongoing */
    PrevXferComplete = 0;

    /* Copy mouse position info in ENDP1 Tx Packet Memory Area*/
    USB_SIL_Write(EP1_IN, Mouse_Buffer, 4);

    /* Enable endpoint for transmission */
    SetEPTxValid(ENDP1);
  }
}

/**
  * Function Name : Keyboard_Send.
  * Description   : prepares buffer to be sent containing keybaord event infos.
  * Input         : CalibData pointer to the structure containing mapping of the
  *                 key values.
  * Output        : None.
  * Return value  : None.
  */
void Keyboard_Send(calib_data_t *CalibData)
{
    assert_param(NUM_KEYS < 32);

    static uint32_t btn_state;
    register uint32_t data = 0;

    data = GPIO_ReadInputData(KEY_PORT) & KEY_MASK;
    if (btn_state != data) {
        int i = 0, j = 0;
        uint8_t Keyboard_Buffer[2 + KEY_USB_DESC_MAX] = {2, };

        btn_state = data;
        while (data && (i < KEY_USB_DESC_MAX) && (j < NUM_KEYS)) {
            if (data & keys[j]) {
                data &= ~keys[j];
                if (CalibData->st.KeyMap[j] >= 0xE0 && CalibData->st.KeyMap[j] < 0xE8) {
                    /* LCtrl, LShift, LAlt, LGUI, RCtrl, ... */
                    Keyboard_Buffer[1] |= 1 << (CalibData->st.KeyMap[j] & 0xF);
                } else {
                    Keyboard_Buffer[2 + i++] = CalibData->st.KeyMap[j];
                }
            }
            ++j;
        }
        /* Reset the control token to inform upper layer that a transfer is ongoing */
        PrevXferComplete = 0;

        /* Copy mouse position info in ENDP1 Tx Packet Memory Area*/
        USB_SIL_Write(EP1_IN, Keyboard_Buffer, 2 + KEY_USB_DESC_MAX);

        /* Enable endpoint for transmission */
        SetEPTxValid(ENDP1);
    }
}
/**
  * Function Name : calibrate_cmd_process.
  * Description   : Process calibration command.
  * Input         : cmdBuff - command buffer,
  *                 CalData - calibration data structure,
  *                 JoySet - joystick settings structure
  * Output        : None.
  * Return value  : None.
  */
void calibrate_cmd_process(volatile uint8_t *cmdBuff, calib_data_t **CalData, JoySettings_t *JoySet)
{
    uint8_t buf[ALIGN(sizeof(calib_data_t) + 1, 2)] = {3, };
    calib_data_t *buf_w = (calib_data_t *)&buf[1];
    static uint16_t count = 1,
                    CalibXmin = 0xffff,
                    CalibXmax = 0,
                    CalibYmax = 0,
                    CalibYmin = 0xffff;
    static int16_t  CalibXavg = 0,
                    CalibYavg = 0;

    switch (cmdBuff[1]) {
    case CALIBRATE_RANGE:
        while ((cmdBuff[0] == REP_CALIBRATE) && (cmdBuff[1] != CALIBRATE_RANGE_STOP)) {
            ADC_avg_read(ADC_SAMPLE_COUNT, JoySet->X_map, JoySet->Y_map);
            CalibXmax = MAX(CalibXmax, X);
            CalibXmin = MIN(CalibXmin, X);
            CalibYmax = MAX(CalibYmax, Y);
            CalibYmin = MIN(CalibYmin, Y);
        }
        buf_w->st = (*CalData)->st;
        buf_w->st.Xmax = CalibXmax;
        buf_w->st.Xmin = CalibXmin;
        buf_w->st.Ymax = CalibYmax;
        buf_w->st.Ymin = CalibYmin;
        *CalData = flash_claib_write(*CalData, buf_w);
        JoystickCalibrated = flash_check_calibrated(*CalData);
        Joystick_setup(*CalData, JoySet);
        CalibXmax = 0;
        CalibYmax = 0;
        CalibXmin = 0xffff;
        CalibYmin = 0xffff;
        if (cmdBuff[0] == REP_CALIBRATE)
            cmdBuff[0] = 0;
        break;
    case CALIBRATE_AVG:
        while ((cmdBuff[0] == REP_CALIBRATE) && (cmdBuff[1] != CALIBRATE_AVG_STOP)) {
            ADC_avg_read(ADC_SAMPLE_COUNT, JoySet->X_map, JoySet->Y_map);
            CalibXavg += ((int16_t)X - CalibXavg) / count;
            CalibYavg += ((int16_t)Y - CalibYavg) / count;
            count++;
        }
        buf_w->st = (*CalData)->st;
        buf_w->st.Xavg = CalibXavg;
        buf_w->st.Yavg = CalibYavg;
        *CalData = flash_claib_write(*CalData, buf_w);
        JoystickCalibrated = flash_check_calibrated(*CalData);
        Joystick_setup(*CalData, JoySet);
        CalibXavg = 0;
        CalibYavg = 0;
        count = 1;
        if (cmdBuff[0] == REP_CALIBRATE)
            cmdBuff[0] = 0;
        break;
    case CALIBRATE_MANUAL:
        *CalData = flash_claib_write(*CalData, (calib_data_t *)&cmdBuff[2]);
        JoystickCalibrated = flash_check_calibrated(*CalData);
        Joystick_setup(*CalData, JoySet);
        if (cmdBuff[0] == REP_CALIBRATE)
            cmdBuff[0] = 0;
        break;
    case CALIBRATE_SHOW:
        buf_w->st = (*CalData)->st;
        if (PrevXferComplete == 1) {
            PrevXferComplete = 0;
            USB_SIL_Write(EP1_IN, buf, sizeof(calib_data_t) + 1);
            SetEPTxValid(ENDP1);
            if (cmdBuff[0] == REP_CALIBRATE)
                cmdBuff[0] = 0;
        }
        break;
    case CALIBRATE_DEBUG:
        if (PrevXferComplete == 1) {
            PrevXferComplete = 0;
            ADC_avg_read(ADC_SAMPLE_COUNT, JoySet->X_map, JoySet->Y_map);
            *(uint16_t *)&buf[1] = *JoySet->X_map;
            *(uint16_t *)&buf[3] = *JoySet->Y_map;
            USB_SIL_Write(EP1_IN, buf, 5);
            SetEPTxValid(ENDP1);
            if (cmdBuff[0] == REP_CALIBRATE)
                cmdBuff[0] = 0;
        }
        break;
    }
}

/**
  * @brief  Inserts a delay time.
  * @param  nTime: specifies the delay time length, in milliseconds.
  * @retval None
  */
static void Delay(__IO uint32_t nTime)
{
  for(; nTime != 0; nTime--);
}

/**
  * Function Name  : Get_SerialNum.
  * Description    : Create the serial number string descriptor.
  * Input          : None.
  * Output         : None.
  * Return         : None.
  */
void Get_SerialNum(void)
{
  uint32_t Device_Serial0, Device_Serial1, Device_Serial2;

  Device_Serial0 = *(uint32_t*)ID1;
  Device_Serial1 = *(uint32_t*)ID2;
  Device_Serial2 = *(uint32_t*)ID3;

  Device_Serial0 += Device_Serial2;

  if (Device_Serial0 != 0)
  {
    IntToUnicode (Device_Serial0, &Joystick_StringSerial[2] , 8);
    IntToUnicode (Device_Serial1, &Joystick_StringSerial[18], 4);
  }
}

/**
  * Function Name  : HexToChar.
  * Description    : Convert Hex 32Bits value into char.
  * Input          : None.
  * Output         : None.
  * Return         : None.
  */
static void IntToUnicode (uint32_t value , uint8_t *pbuf , uint8_t len)
{
  uint8_t idx = 0;

  for( idx = 0 ; idx < len ; idx ++)
  {
    if( ((value >> 28)) < 0xA )
    {
      pbuf[ 2* idx] = (value >> 28) + '0';
    }
    else
    {
      pbuf[2* idx] = (value >> 28) + 'A' - 10; 
    }

    value = value << 4;

    pbuf[ 2* idx + 1] = 0;
  }
}

/************************ (C) COPYRIGHT STMicroelectronics *****END OF FILE****/
