nopasara/joystick/src/stm32_it.c

/**
  ******************************************************************************
  * @file    stm32_it.c
  * @author  MCD Application Team
  * @version V4.1.0
  * @date    26-May-2017
  * @brief   Main Interrupt Service Routines.
  *          This file provides template for all exceptions handler and peripherals
  *          interrupt service routine.
  ******************************************************************************
  * @attention
  *
  * <h2><center>&copy; COPYRIGHT(c) 2017 STMicroelectronics</center></h2>
  *
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
  ******************************************************************************
  */


/* Includes ------------------------------------------------------------------*/
#include "stm32_it.h"
#include "hw_config.h"
/* Private typedef -----------------------------------------------------------*/
/* Private define ------------------------------------------------------------*/
/* Private macro -------------------------------------------------------------*/
/* Private variables ---------------------------------------------------------*/
extern __IO uint32_t DevRemoteWakeup;
/* Private function prototypes -----------------------------------------------*/
/* Private functions ---------------------------------------------------------*/

/******************************************************************************/
/*            Cortex-M Processor Exceptions Handlers                         */
/******************************************************************************/

/**
  * Function Name  : NMI_Handler
  * Description    : This function handles NMI exception.
  * Input          : None
  * Output         : None
  * Return         : None
  */
void NMI_Handler(void)
{
}

/**
  * Function Name  : HardFault_Handler
  * Description    : This function handles Hard Fault exception.
  * Input          : None
  * Output         : None
  * Return         : None
  */
void HardFault_Handler(void)
{
  /* Go to infinite loop when Hard Fault exception occurs */
  while (1)
  {
  }
}

/**
  * Function Name  : MemManage_Handler
  * Description    : This function handles Memory Manage exception.
  * Input          : None
  * Output         : None
  * Return         : None
  */
void MemManage_Handler(void)
{
  /* Go to infinite loop when Memory Manage exception occurs */
  while (1)
  {
  }
}

/**
  * Function Name  : BusFault_Handler
  * Description    : This function handles Bus Fault exception.
  * Input          : None
  * Output         : None
  * Return         : None
  */
void BusFault_Handler(void)
{
  /* Go to infinite loop when Bus Fault exception occurs */
  while (1)
  {
  }
}

/**
  * Function Name  : UsageFault_Handler
  * Description    : This function handles Usage Fault exception.
  * Input          : None
  * Output         : None
  * Return         : None
  */
void UsageFault_Handler(void)
{
  /* Go to infinite loop when Usage Fault exception occurs */
  while (1)
  {
  }
}

/**
  * Function Name  : SVC_Handler
  * Description    : This function handles SVCall exception.
  * Input          : None
  * Output         : None
  * Return         : None
  */
void SVC_Handler(void)
{
}

/**
  * Function Name  : DebugMon_Handler
  * Description    : This function handles Debug Monitor exception.
  * Input          : None
  * Output         : None
  * Return         : None
  */
void DebugMon_Handler(void)
{
}

/**
  * Function Name  : PendSV_Handler
  * Description    : This function handles PendSVC exception.
  * Input          : None
  * Output         : None
  * Return         : None
  */
void PendSV_Handler(void)
{
}

/**
  * Function Name  : SysTick_Handler
  * Description    : This function handles SysTick Handler.
  * Input          : None
  * Output         : None
  * Return         : None
  */
void SysTick_Handler(void)
{
}

/******************************************************************************/
/*                 STM32 Peripherals Interrupt Handlers                       */
/*  Add here the Interrupt Handler for the used peripheral(s) (PPP), for the  */
/*  available peripheral interrupt handler's name please refer to the startup */
/*  file (startup_stm32xxx.s).                                                */
/******************************************************************************/

/**
  * Function Name  : USB_IRQHandler
  * Description    : This function handles USB Low Priority interrupts
  *                  requests.
  * Input          : None
  * Output         : None
  * Return         : None
  */
#if defined(STM32L1XX_MD) || defined(STM32L1XX_HD)|| defined(STM32L1XX_MD_PLUS) || defined(STM32F37X)
void USB_LP_IRQHandler(void)
#else
void USB_LP_CAN1_RX0_IRQHandler(void)
#endif
{
  USB_Istr();
}

void USB_FS_WKUP_IRQHandler(void)
{
  EXTI_ClearITPendingBit(EXTI_Line18);
}

/**
  * Function Name  : USBWakeUp_IRQHandler
  * Description    : This function handles USB WakeUp interrupt request.
  * Input          : None
  * Output         : None
  * Return         : None
  */
void USBWakeUp_IRQHandler(void)
{
  EXTI_ClearITPendingBit(EXTI_Line18);
}

/**
  * Function Name  : TIM1_UP_IRQHandler
  * Description    : This function handles Timer1 update interrupt request.
  * Input          : None
  * Output         : None
  * Return         : None
  */

void TIM1_UP_IRQHandler(void)
{
  static int led_state;

  TIM_ClearFlag(TIM1, TIM_FLAG_Update);
  led_state ^= 1;
  GPIO_WriteBit(KEY_PORT, KEY_LED, led_state);
  if (JoystickCalibrated) {
    GPIO_WriteBit(KEY_PORT, KEY_LED, 0);
    Signal_Unconfigured(DISABLE);
  }
}
/************************ (C) COPYRIGHT STMicroelectronics *****END OF FILE****/
