nopasara/joystick/(commit log)

2021-08-06 Initial joystick project commit
    The USB joystick project on the STM32F103 MCU that consists of a JoyCon
    stick and 8 keyboard switches. The project contains the firmware and
    KiCad project with shcemas
    [joystick.kicad_pcb, joystick.sch, keypad.kicad_pcb, keypad.sch]
2021-09-19 Add labels to keyboard pins
    Add labels to keyboard pins in order to have explicit key->port B pins
    mapping
    [joystick.sch, keypad.sch]
2021-09-19 Fix KeyMap indexing
    Fix the operation order by adding braces and add incremental key index
    calculation logic
    [hw_config.c]
2021-09-19 Fix key mappings
    Fix the key mappings and descriptor in order to match 1-8 charecter
    range
    [main.c]
2022-01-29 Add new joystick shcematics
    Add schematics for keyboard and jouystick adaptors
    [joystick.kicad_pcb, joystick.sch, joystick_v2.kicad_pcb, joystick_v2.sch, stick_adaptor.kicad_pcb, stick_adaptor.sch, stick_adaptor2.kicad_pcb, stick_adaptor2.sch]
2022-01-29 Updated code for the new schematics
